PabloO1234/Digitalizador-de-libros/Diapositivas_presentacion_23DIC2014.pdf

# ESCÁNER DE LIBROS

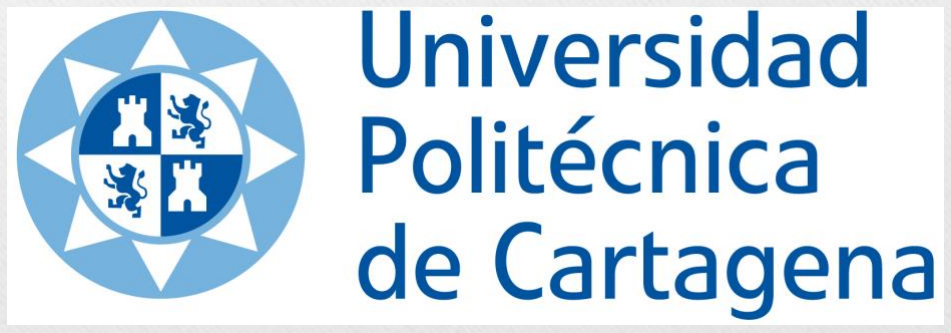
[picture p1: figure]

Mario navarro
Pablo otón

# Prototipo presentado:

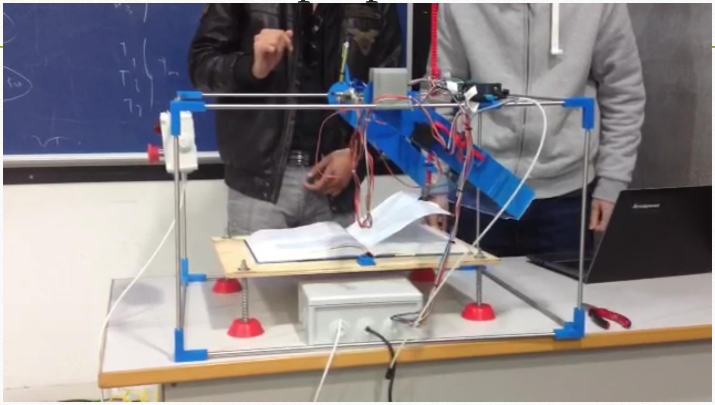
[picture p2: figure]

# ANTECEDENTES

- Existen ya diseños de escáner de libros con giro de página automático.

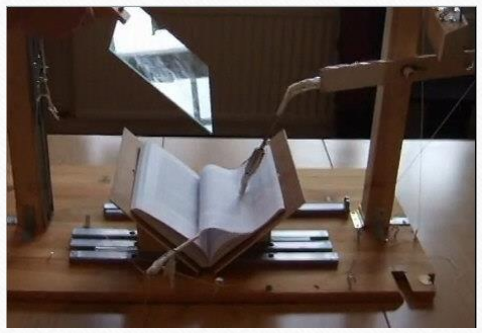
[picture p3: figure]

Ejemplos:

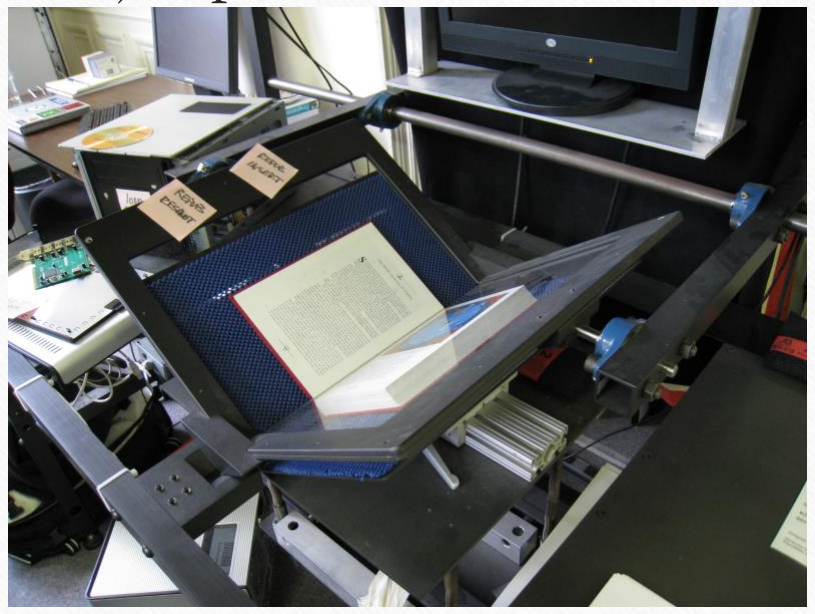
[picture p4: figure]
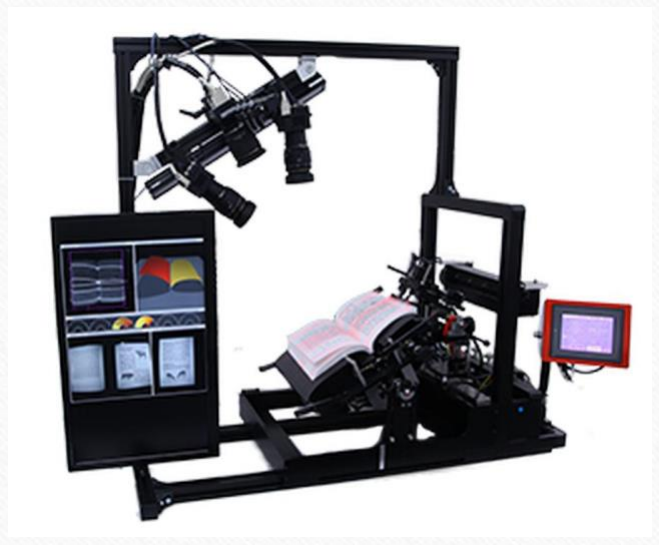
[picture p5: figure]

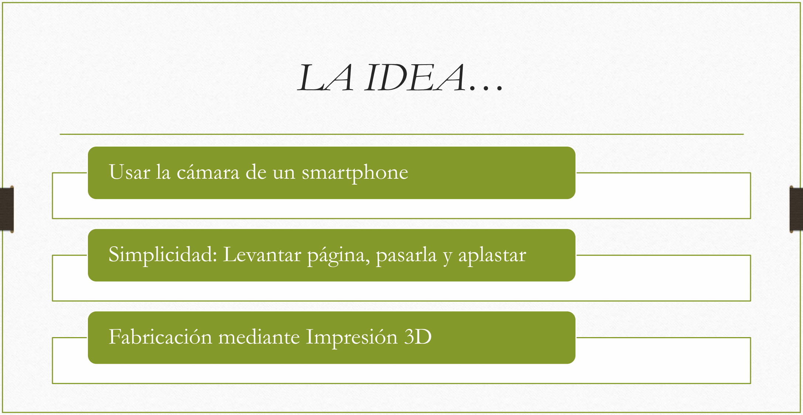
[picture p6: figure]
LA IDEA…; Usar la cámara de un smartphone; Fabricación mediante Impresión 3D

Simplicidad: Levantar página, pasarla y aplastar

# Concibiendo la idea: SolidWorks

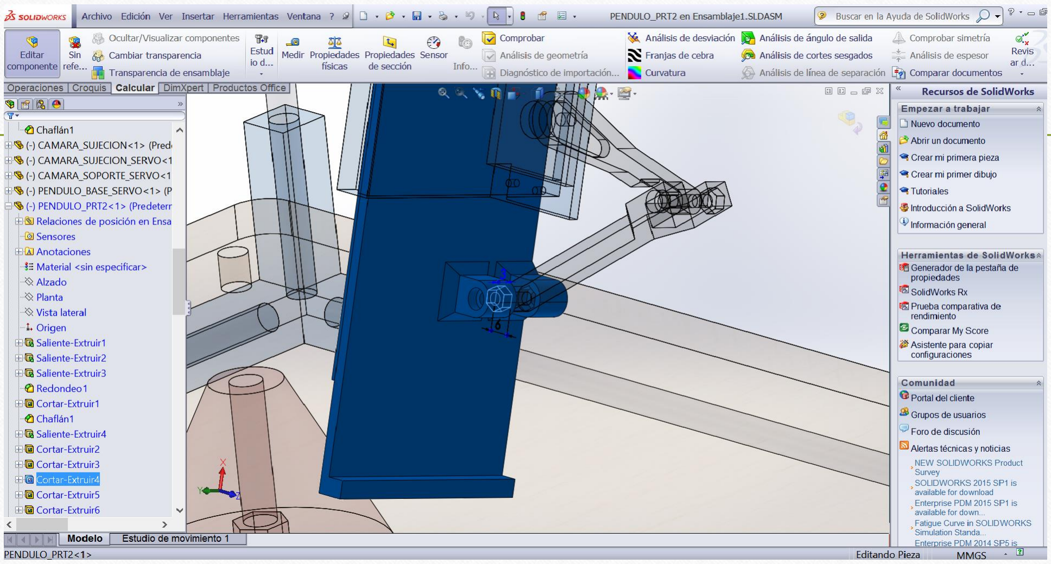
[picture p7: figure]

# Concibiendo la idea: SolidWorks

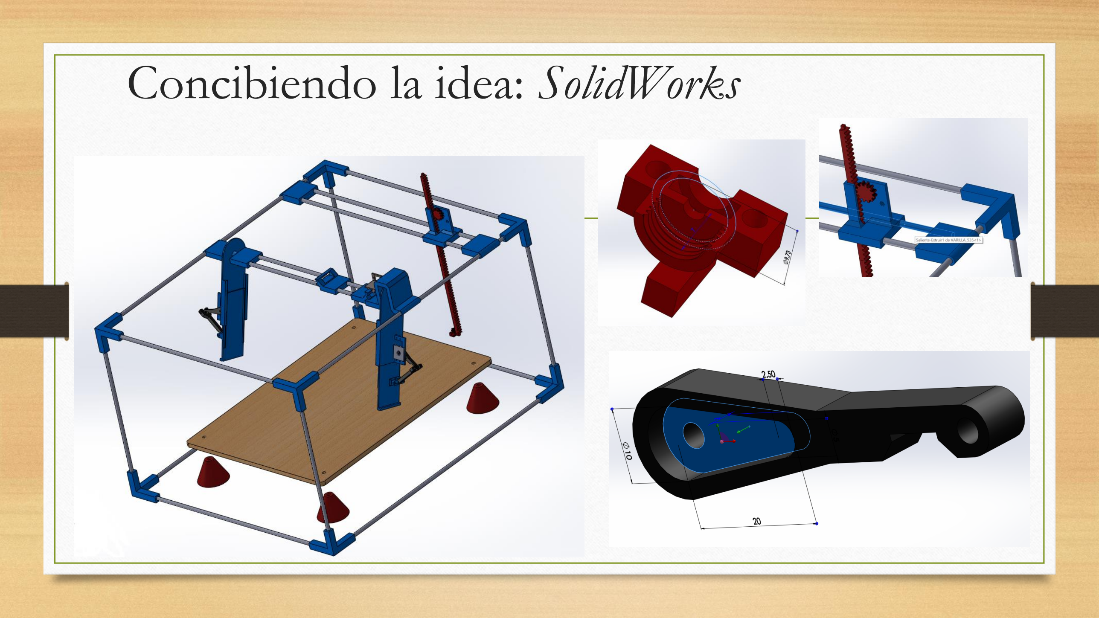
[picture p8: page 6]

# Actuadores usados y electrónica

- Servomotores de robótica: digitales, piñonería metálica, 14 Kg cm.
- Motor paso a paso unipolar de 4 electroimanes. Usaremos transistores de alta ganancia “Darlington”, en concreto un array de transistores en un integrado, para activar cada electroimán (500 mA).
- Final de carrera mecánico para la ventosa (el motor no codifica posición en valor absoluto).
- Un microcontrolador ATMega 328P, programado en C con la IDE de Arduino.
- Relé para controlar la neumática a 24V.
- Electrovávula de dos posiciones y dos vías, retorno por muelle.
- Compresor de 8 bares y 25 litros de depósito como fuente.
- Fuentes de 12V y 24V.
- Electrónica accesoria, como reguladores lineales, resistencias, cableado, etc.

# SECUENCIA, ciclo de funcionamiento

1. El operario sitúa el libro, ajusta el final de carrera de la ventosa según el tamaño del

libro (ya fijado) y enciende la máquina, que toma la posición retraída de la ventosa.
1. Se retrae el péndulo.
2. Desciende la ventosa, se activa la electroválvula.
3. Sube la ventosa con una página.
4. El péndulo se mueve al centro sobre el libro, pasando por debajo de la página elevada y “pasándola”. Simultáneamente se desactiva la ventosa.
5. El péndulo desciende verticalmente para evitar la deformación y se activa el servo que toma la foto y se retira.
6. Al mismo tiempo, se retrae la ventosa para desaparecer del campo visual.
7. Se vuelve a repetir el ciclo desde el punto nº2 hasta finalizar el libro.

# Motor paso a paso

- Para el control del motor paso a paso de la cremallera de la ventosa hemos implementado una librería en Arduino, llamada ‘Unipolar’ siguiendo la secuencia de pulsos que especifica el fabricante.
- Existen librerías que podrían mover el motor, pero hacen falta varias líneas de código para especificar los pasos, las rpm…
- Sabiendo que queríamos mover el motor siempre a la misma velocidad y no queríamos controlarlo especificando el Nº de pasos sino con los Eventos de la secuencia hemos implementado una librería más simple, específica para nuestros requerimientos.
- Tres funciones nos permiten en cada estado, controlar el motor con una sola línea: ‘motor.giraderecha’ ‘motor.giraizquierda’ ‘motor.para’

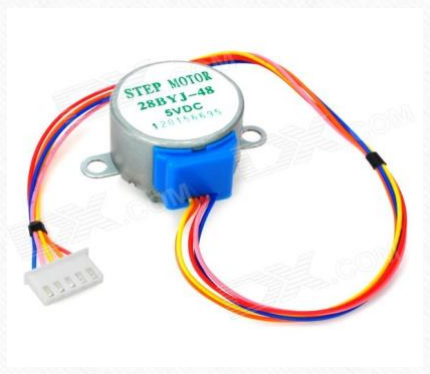
[picture p9: figure]
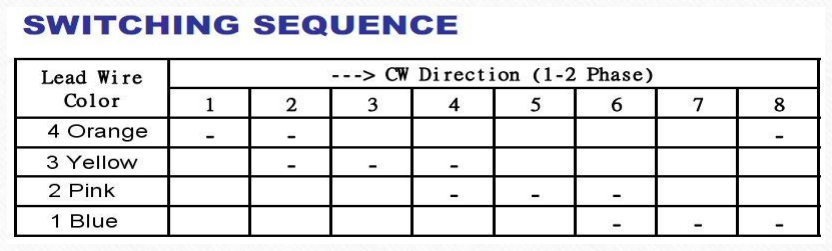
[picture p10: figure]

# HARDWARE: ULN2003

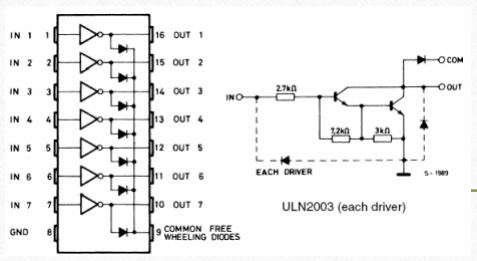
[picture p11: figure]

- Encapsulado con 7 transistores Darlington (alta ganancia).

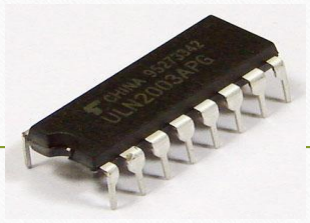
[picture p12: figure]

- Para amplificar la corriente del motor paso a paso unipolar hemos usado 4 de los 7 de transistores Darlington que incorpora el integrado.
- Hemos usado 1 transistor del encapsulado para excitar el relé de la electroválvula solenoide.
- VENTAJAS: Comodidad de uso. Ya incorpora la resistencia limitadora de la base y los diodos en antiparalelo para proteger antes cargas inductivas. Enchufar y listo.

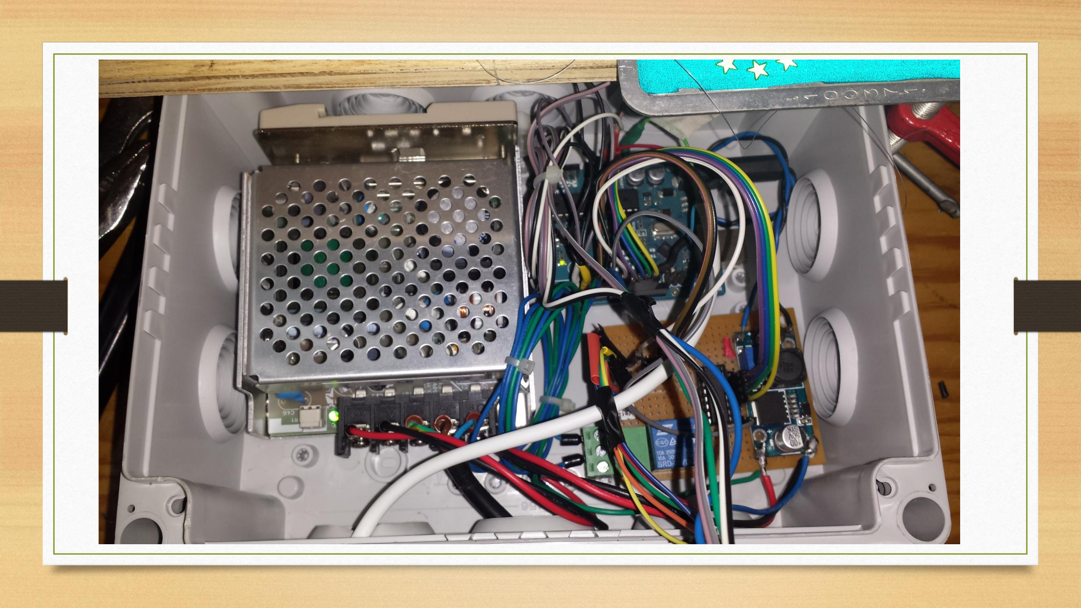
[picture p13: page 11]

# GRAFCET nivel II

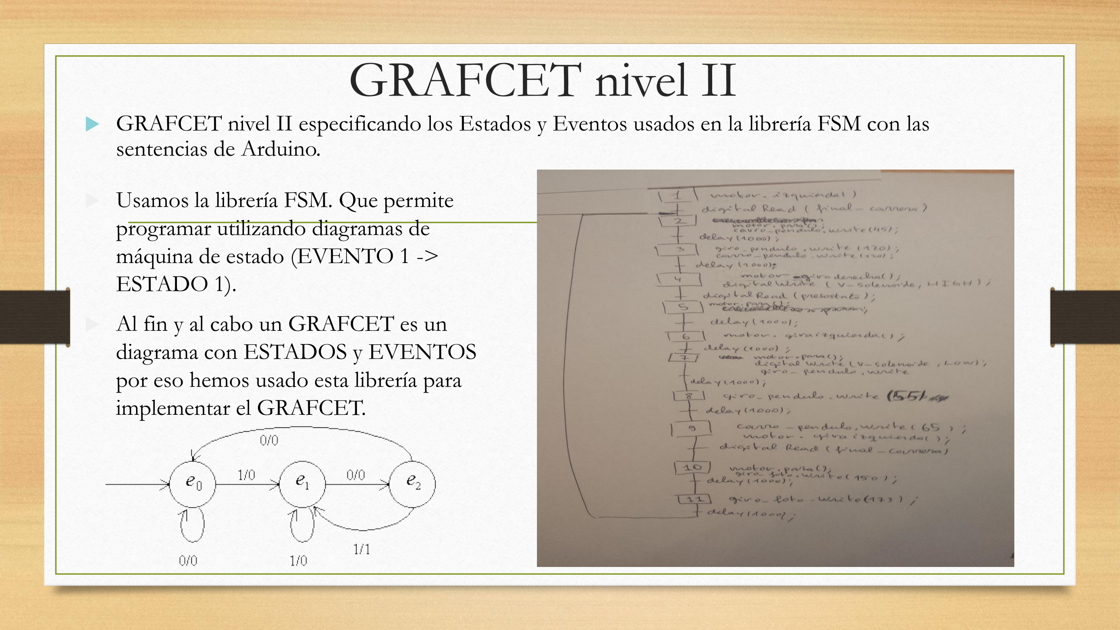
[picture p14: page 12]

- GRAFCET nivel II especificando los Estados y Eventos usados en la librería FSM con las sentencias de Arduino.
- Usamos la librería FSM. Que permite
programar utilizando diagramas de
máquina de estado (EVENTO 1 -> ESTADO 1).
- Al fin y al cabo un GRAFCET es un diagrama con ESTADOS y EVENTOS por eso hemos usado esta librería para implementar el GRAFCET.

# ARDUINO vs AUTÓMATA

AUTOMATA
- Actualización de E/S
- Ejecución del programa
- Servicio a periféricos

ARDUINO

- Ejecuta en bucle el programa leyendo y actualizando las E/S según código.
- Dispone de librerías como la del control de servos.
- El ciclo de funcionamiento es diferente. Arduino no puede trabajar de manera combinacional, aunque va lo suficientemente rápido como para no notarlo en esta aplicación en concreto.
- Por la versatilidad de Arduino y su fácil implementación, elegimos éste para hacer el prototipo de la máquina.

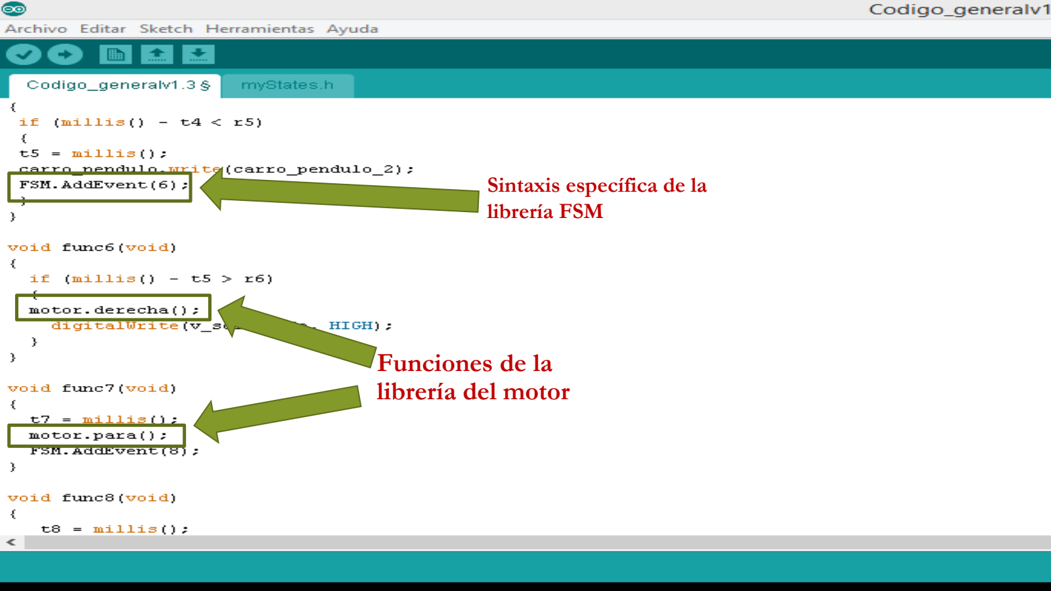
[picture p15: page 14]

Funciones de la
librería del motor

Sintaxis específica de la
librería FSM

# Diagrama de la neumática

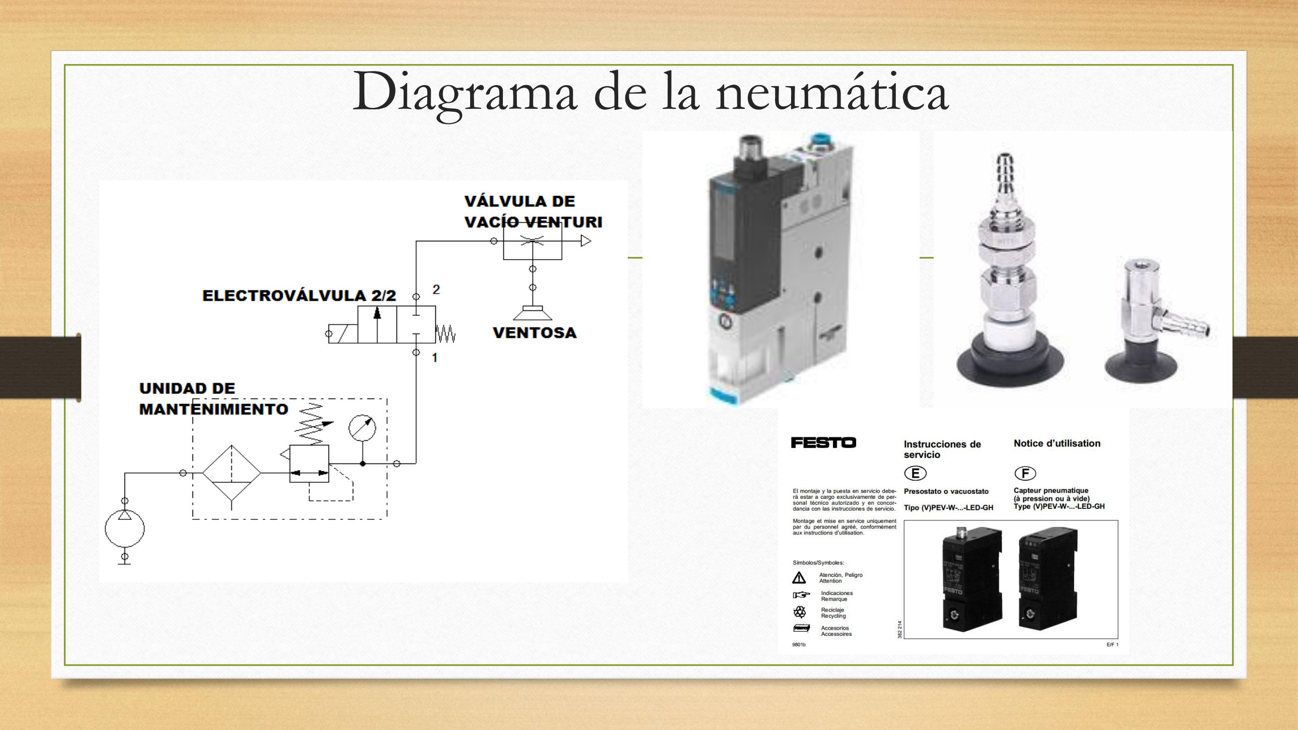
[picture p16: page 15]

# Construyendo el Prototipo

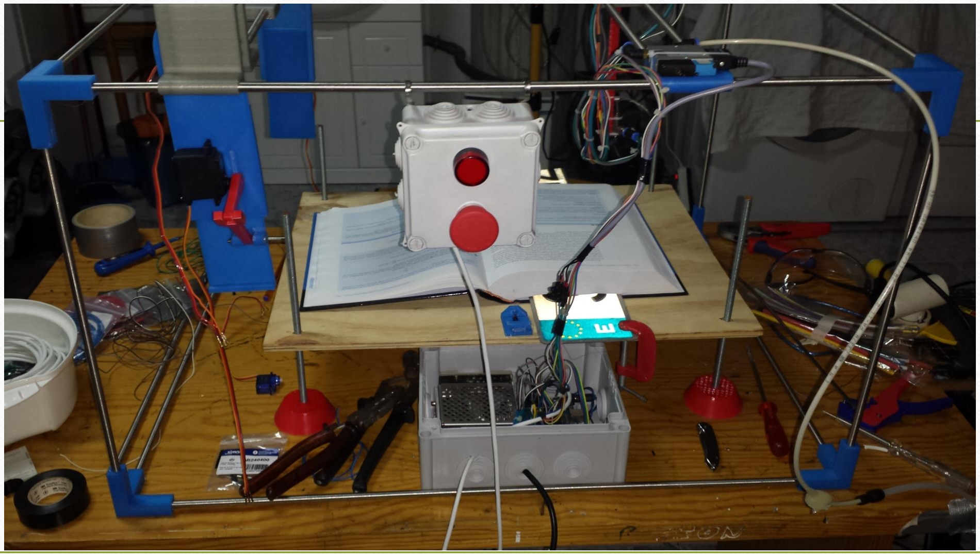
[picture p17: figure]

# El lugar de trabajo

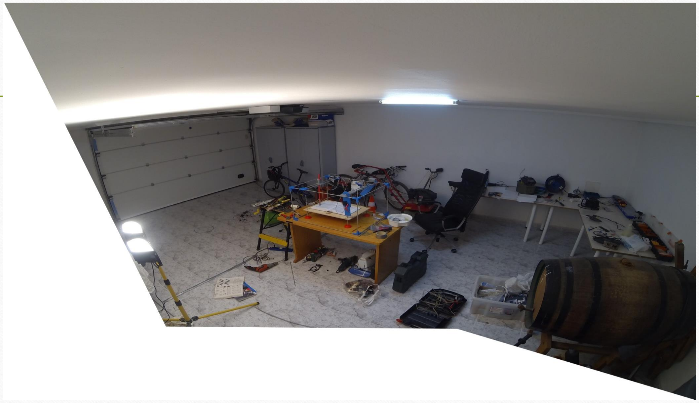
[picture p18: figure]
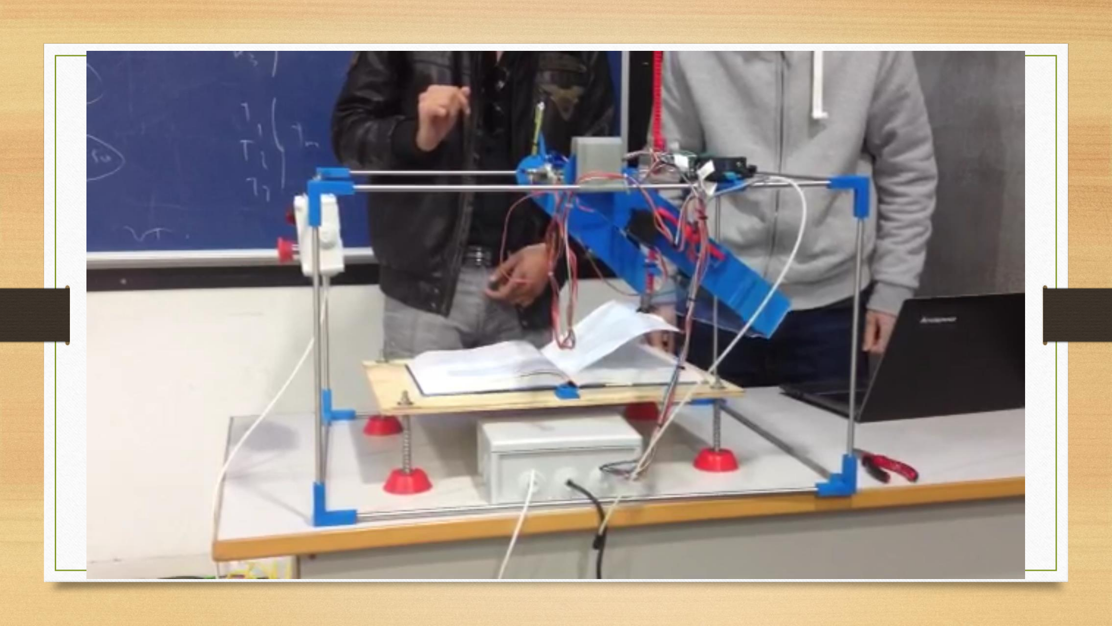
[picture p19: page 18]
